OpenwaterHealth/motion-safety-fpga/(commit log)

2025-04-28 Remove impl1 folder from repository and add Readme
    [Safety_impl1_mapvo.sdf]
2026-01-17 update
    pin reassign to support SPI interface
2026-02-20 PDC sample at 160
2026-02-25 enable i2c firmware updates
2026-09-08 Load safety limits from User Flash Memory at boot
    Pulse width, rate and current limits are now read from the MachXO2 UFM at
    startup instead of being fixed at synthesis, so values set after calibration
    survive a firmware update. New ufm_config module reads the record over the EFB
    WISHBONE configuration port and writes it into the register file. If the UFM is
    blank or the record fails its magic/checksum, nothing is written and the
    existing hard-coded defaults stand. static_control is not restored — laser
    enable always comes up from reset state.
    Adds read-only registers 0x31 (loader status: 0x2F = calibrated, 0x02 = not)
    and 0x32 (record layout version), tools/make_ufm_record.py to build the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
    [i2c_slave_top.v, registers.v, top.v, ufm_config.v, ufm_config_tb.v, ufm_efb_model.v]
2026-09-08 update calibration data
